RobSot/OBDReader/src/Software_source_code/OBDReader_GUI/images/mil.png

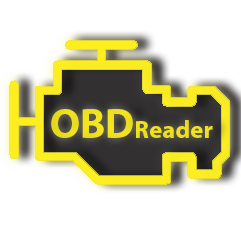
src/Software_source_code/OBDReader_GUI/images/mil.png
