RobSot/OBDReader/src/Software_source_code/OBDReader_GUI/images/pid-gauge.png

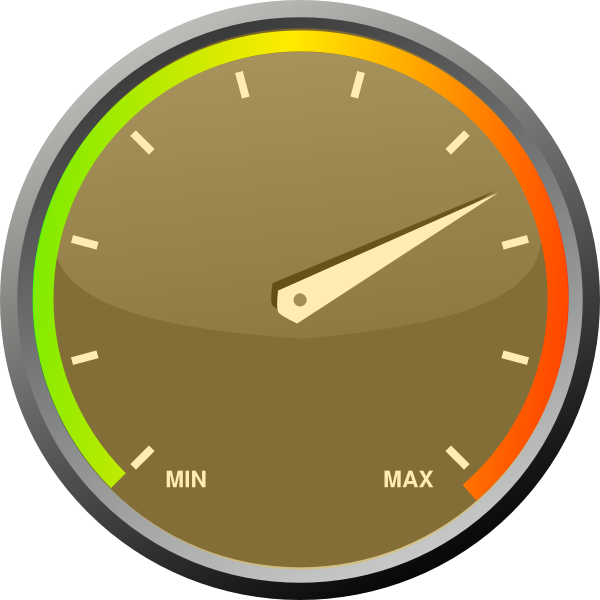
src/Software_source_code/OBDReader_GUI/images/pid-gauge.png
