RobSot/OBDReader/src/Software_source_code/OBDReader_GUI/images/stop-button-red-md.png

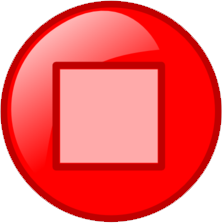
src/Software_source_code/OBDReader_GUI/images/stop-button-red-md.png
