RobSot/OBDReader/pcb/OBD_Reader.brd

## EAGLE design pcb/OBD_Reader.brd (2015-04-29)

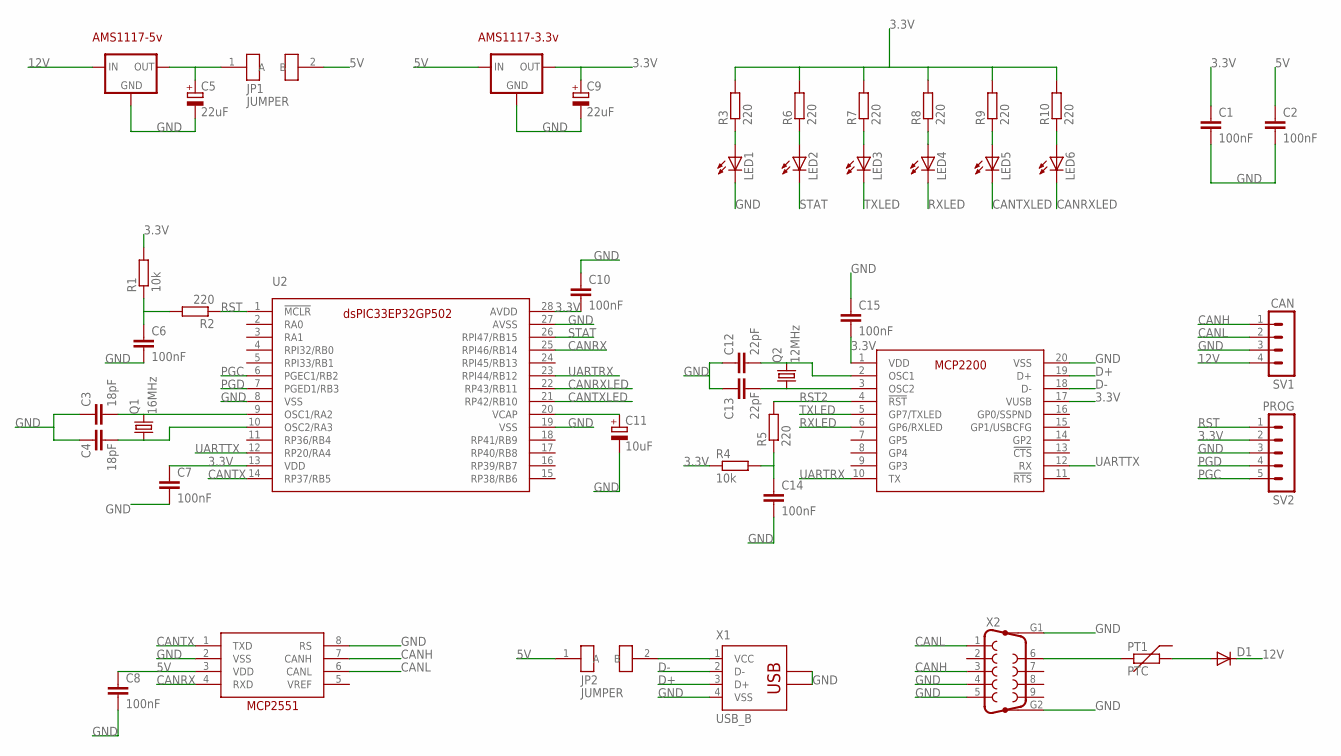
[picture p4: schematic OBD_Reader.sch]

Parts:
C1, C2, C6, C7, C8, C10, C14, C15: 100nF; C0603
C3, C4: 18pF; C0603
C5, C9: 22uF; CT3216
C11: 10uF; CT3216
C12, C13: 22pF; C0603
D1: DIODE-SMB; SMB
JP1, JP2: JUMPER; 1206
LED1, LED2, LED3, LED4, LED5, LED6: LEDCHIPLED_0603; CHIPLED_0603
PT1: PTC; PTC_1206
Q1: 16MHz; HC49/S
Q2: 12MHz; HC49/S
R1, R4: 10k; R0603
R2, R3, R5, R6, R7, R8, R9, R10: 220; R0603
SV1: CAN; MA04-1
SV2: PROG; MA05-1
U1: AMS1117_5V; SOT-223
U2: DSPIC33EP32GP502; SSOP28
U3: MCP2551; SOIC20
U4: AMS1117_3.3V; SOT-223
U5: MCP2200; SSOP20
X1: USB_B; 85-32004-00X
X2: F09HP

Connections:
3.3V: C1.1, C7.1, C9.+, C10.2, C15.2, R1.2, R3.2, R4.1, R6.2, R7.2, R8.2, R9.2, R10.2, SV2.2, U2.13 (VDD), U2.28 (AVDD), U4.2 (OUT), U5.1 (VDD), U5.17 (VUSB)
5V: C2.1, C8.1, JP1.2 (B), JP2.1 (A), U3.3 (VDD), U4.3 (IN)
12V: D1.C, SV1.4, U1.3 (IN)
CANH: SV1.1, U3.7 (CANH), X2.3
CANL: SV1.2, U3.6 (CANL), X2.1
CANRX: U2.25 (RPI46/RB14), U3.4 (RXD)
CANRXLED: LED6.C, U2.22 (RP43/RB11)
CANTX: U2.14 (RP37/RB5), U3.1 (TXD)
CANTXLED: LED5.C, U2.21 (RP42/RB10)
D+: U5.19 (D+), X1.3 (D+)
D-: U5.18 (D-), X1.2 (D-)
GND: C1.2, C2.2, C3.1, C4.1, C5.-, C6.2, C7.2, C8.2, C9.-, C10.1, C11.-, C12.1, C13.1, C14.2, C15.1, LED1.C, SV1.3, SV2.3, U1.1 (GND), U2.8 (VSS), U2.19 (VSS), U2.27 (AVSS), U3.2 (VSS), U3.8 (RS), U4.1 (GND), U5.20 (VSS), X1.4 (VSS), X1.M1 (C1), X1.M2 (C2), X2.4, X2.5, X2.G1, X2.G2
unnamed: C3.2, Q1.2, U2.9 (OSC1/RA2)
unnamed: C4.2, Q1.1, U2.10 (OSC2/RA3)
unnamed: C14.1, R4.2, R5.1
unnamed: C12.2, Q2.2, U5.2 (OSC1)
unnamed: C13.2, Q2.1, U5.3 (OSC2)
unnamed: C6.1, R1.1, R2.2
unnamed: JP2.2 (B), X1.1 (VCC)
unnamed: D1.A, PT1.2
unnamed: PT1.1, X2.6
unnamed: C5.+, JP1.1 (A), U1.2 (OUT)
unnamed: LED1.A, R3.1
unnamed: LED2.A, R6.1
unnamed: LED3.A, R7.1
unnamed: LED4.A, R8.1
unnamed: LED5.A, R9.1
unnamed: LED6.A, R10.1
unnamed: C11.+, U2.20 (VCAP)
PGC: SV2.5, U2.6 (PGEC1/RB2)
PGD: SV2.4, U2.7 (PGED1/RB3)
RST: R2.1, SV2.1, U2.1 (!MCLR)
RST2: R5.2, U5.4 (!RST)
RXLED: LED4.C, U5.6 (GP6/RXLED)
STAT: LED2.C, U2.26 (RPI47/RB15)
TXLED: LED3.C, U5.5 (GP7/TXLED)
UARTRX: U2.23 (RPI44/RB12), U5.10 (TX)
UARTTX: U2.12 (RP20/RA4), U5.12 (RX)

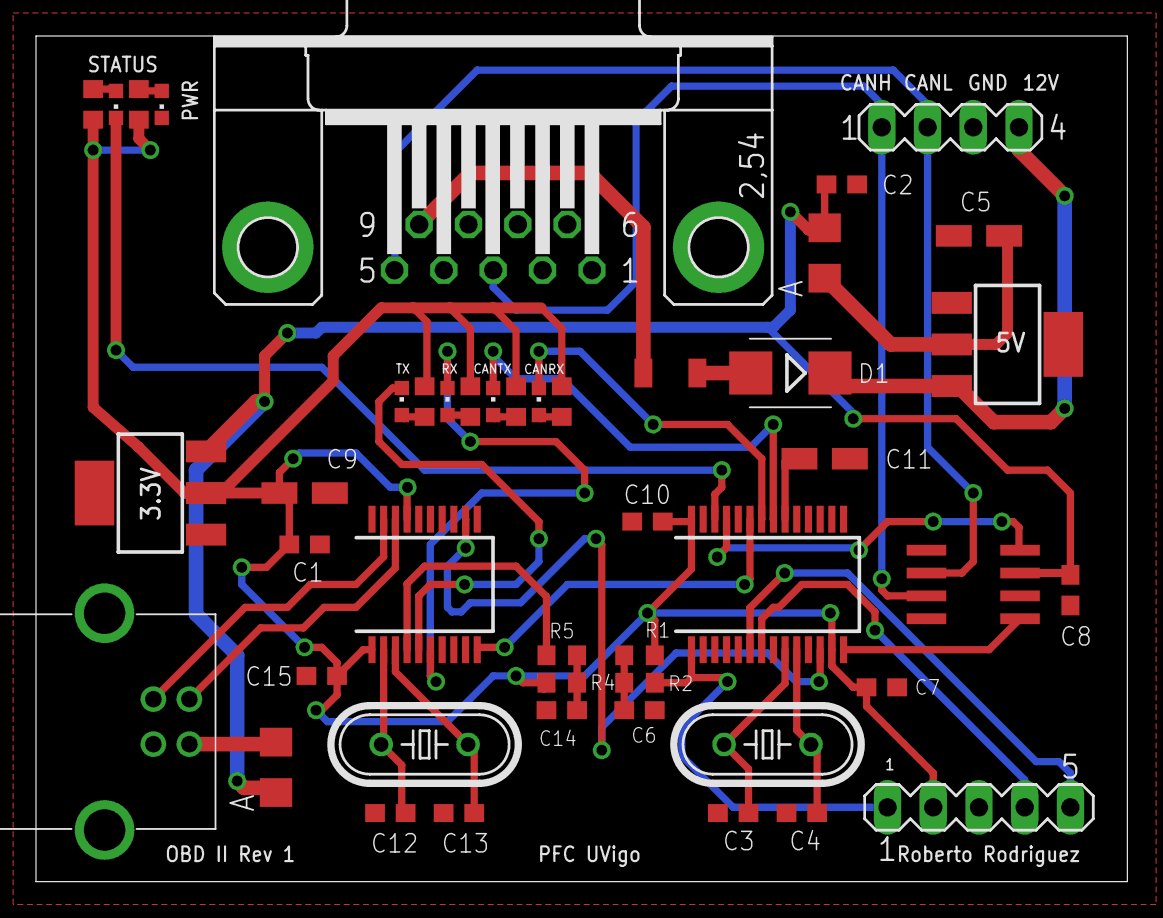
[picture p5: board OBD_Reader.brd from above]

Board: 2 copper layers, 60.6 x 47.0 mm, 46 parts (0 on the bottom side), 38 nets.
