RobSot/OBDReader/(commit log)

2015-04-29 Initial commit. First stage of project
    [BaudRateGeneratorMCP2200.xlsx, BaudRateGeneratorPIC18F.xlsx, BaudRateGeneratorPIC33E.xlsx, OBD_Reader.brd, OBD_Reader.sch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]
2015-08-18 Code refactor and organization. Added new versions
    [BaudRateGeneratorPIC18F.xlsx]
2015-08-29 Added PID selection window on GUI. Some bug fixes.
